makeitrielle/teleport/docs/esp32-a7670e-functional-schematic.png

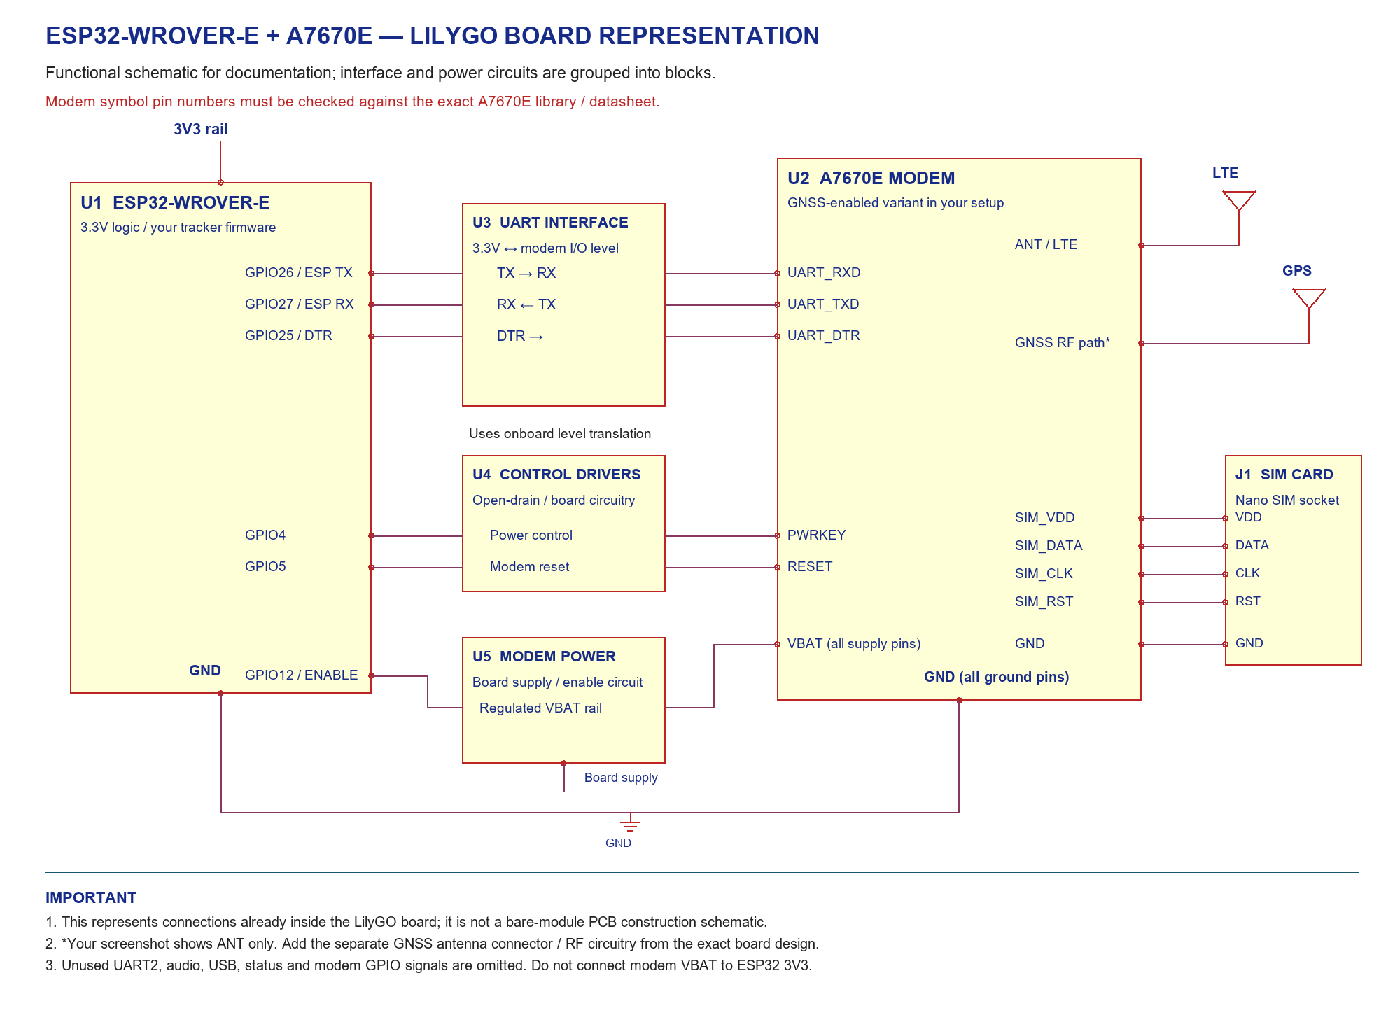
docs/esp32-a7670e-functional-schematic.png
