makeitrielle/teleport/docs/kiosk-connector-schematic.png

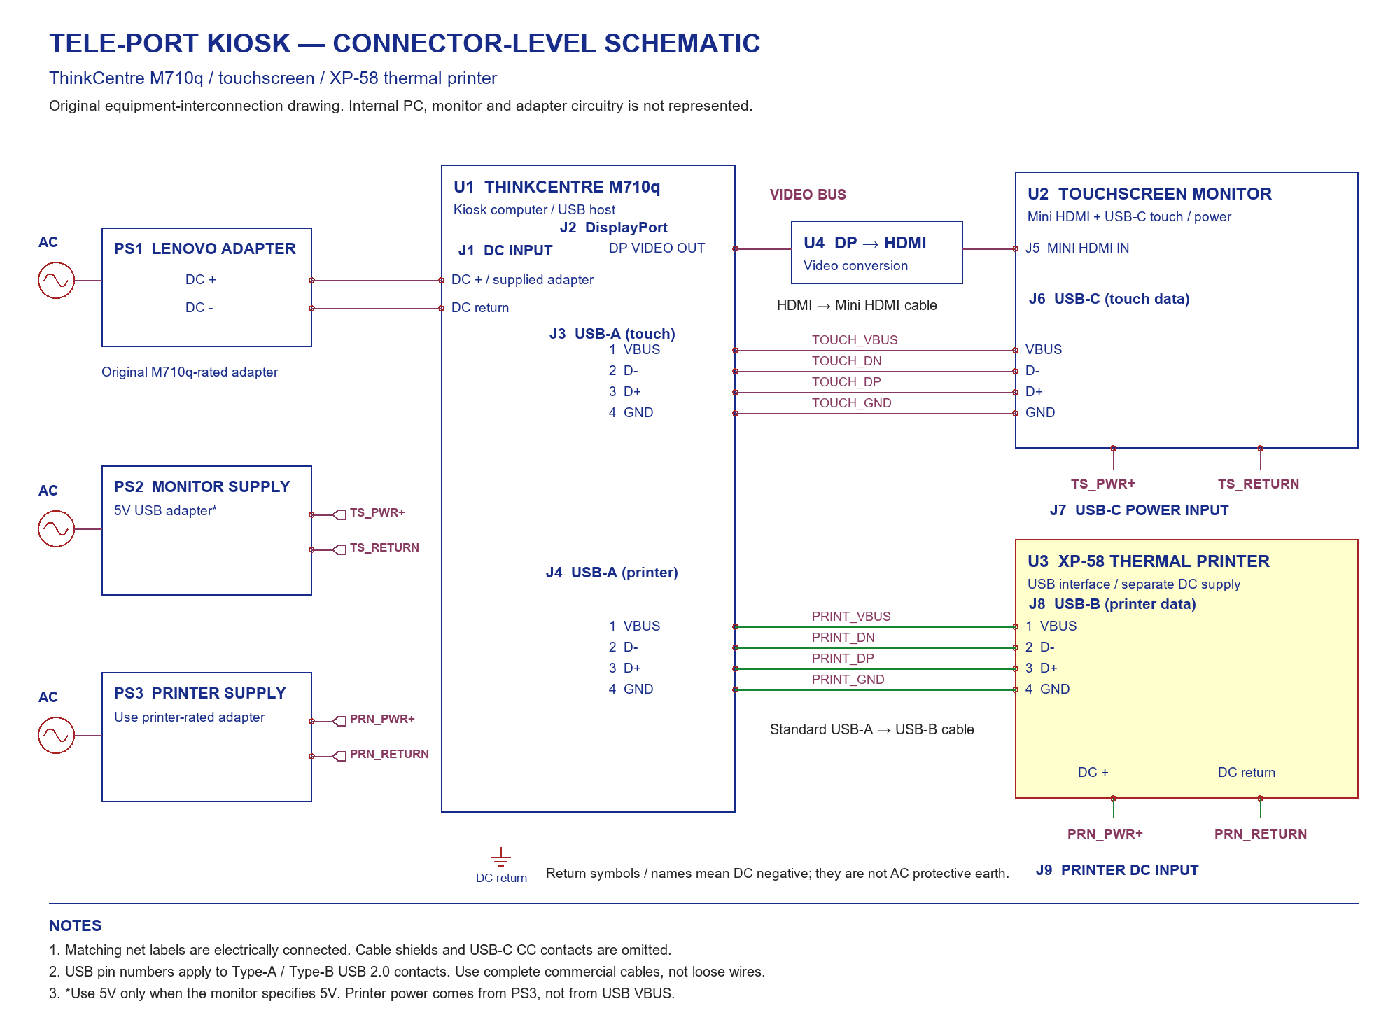
docs/kiosk-connector-schematic.png
