makeitrielle/teleport/tmp-paper-review/corrected-page-5.png

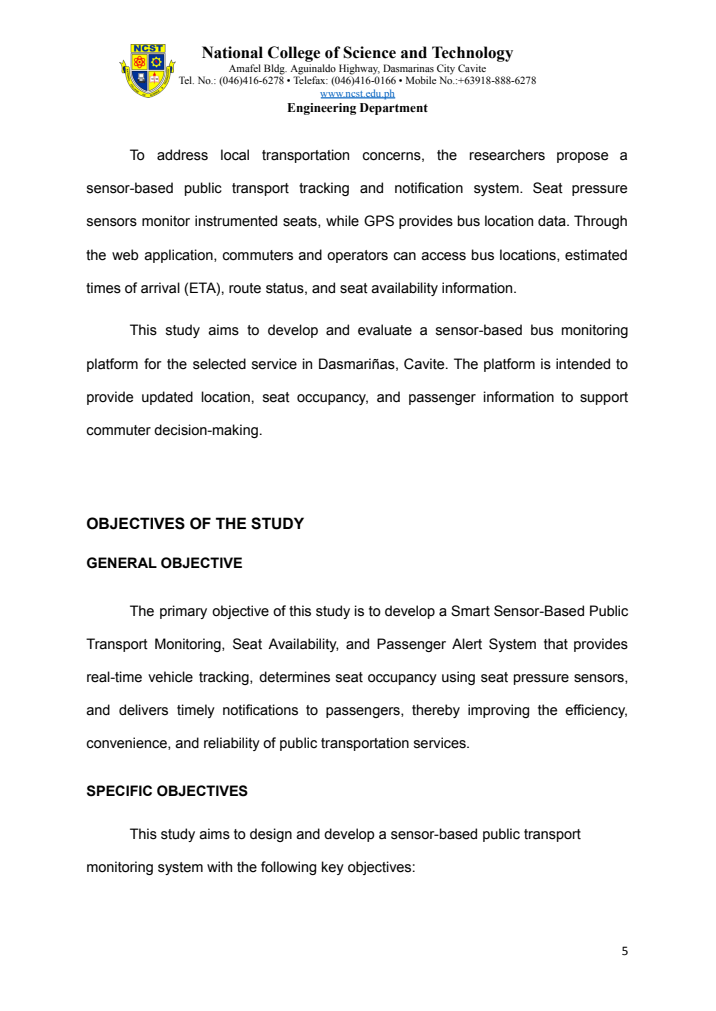
tmp-paper-review/corrected-page-5.png
