makeitrielle/teleport/tmp-paper-review/corrected-page-17.png

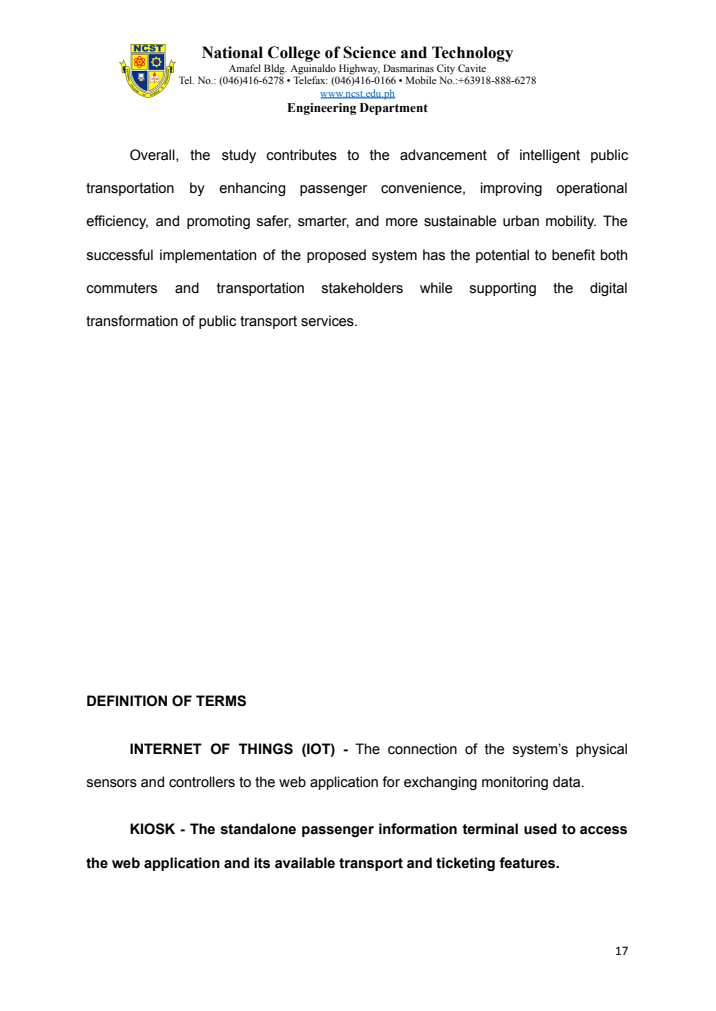
tmp-paper-review/corrected-page-17.png
