makeitrielle/teleport/tmp-paper-review/corrected-page-40.png

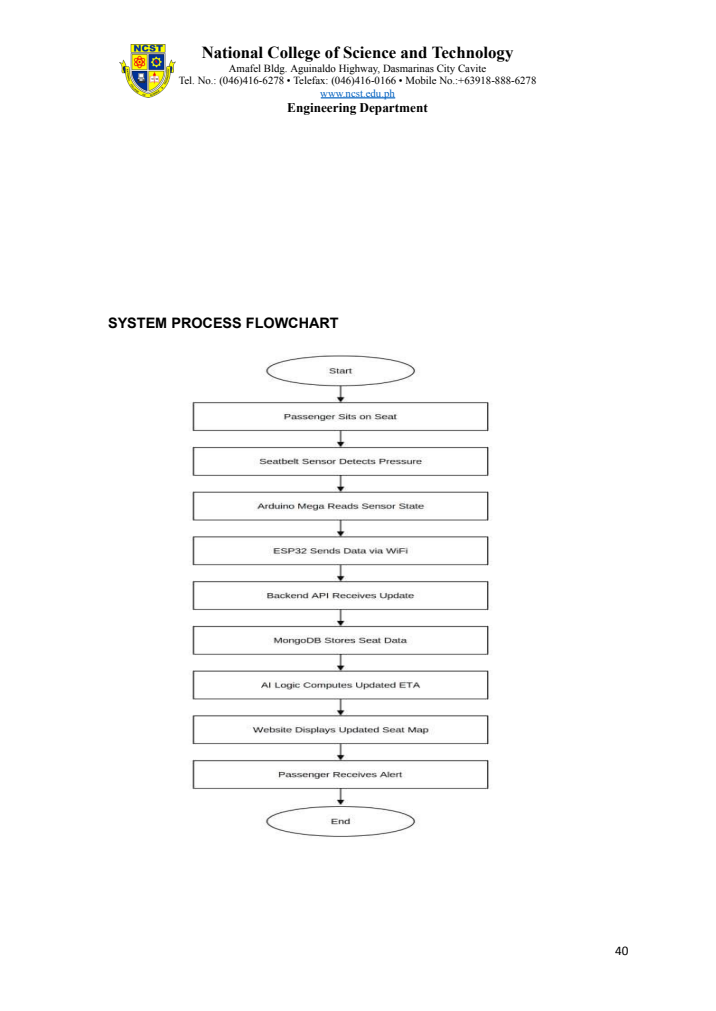
tmp-paper-review/corrected-page-40.png
