makeitrielle/teleport/tmp-paper-review/latest-overview.jpg

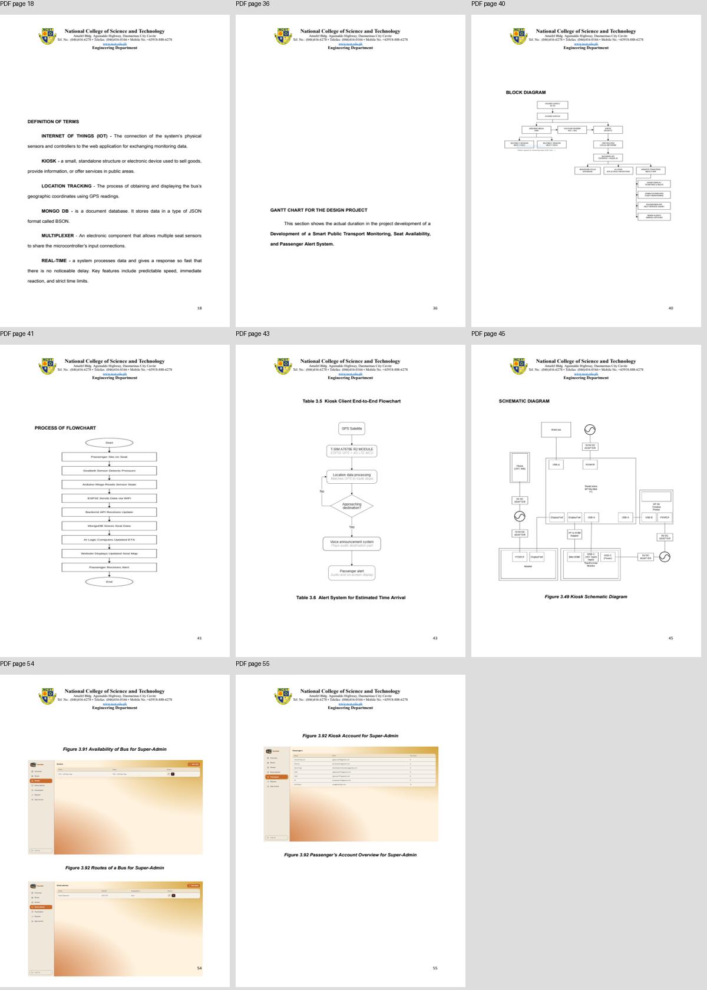
tmp-paper-review/latest-overview.jpg
