makeitrielle/teleport/tmp-paper-review/overview.jpg

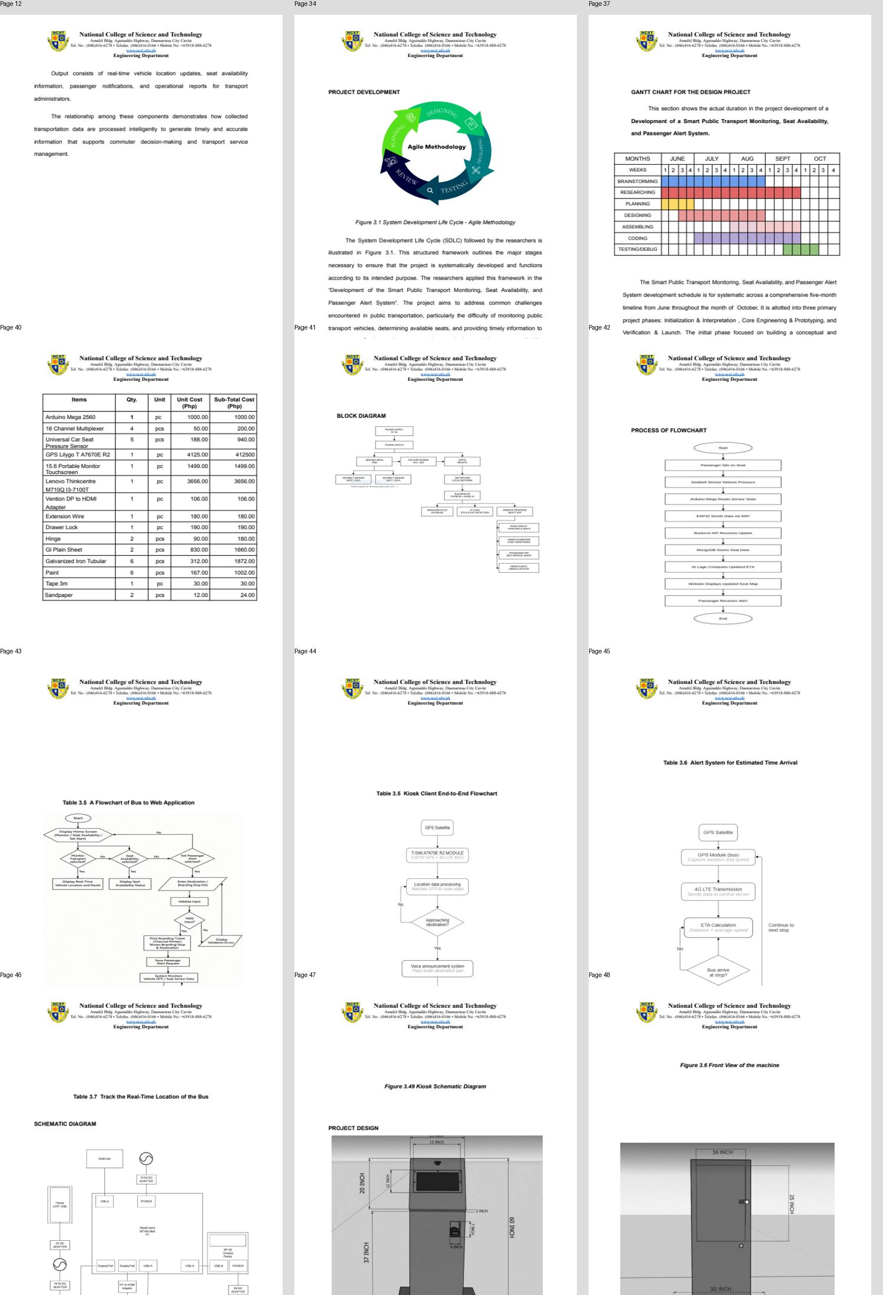
tmp-paper-review/overview.jpg
