makeitrielle/teleport/docs/kiosk-pc-touchscreen-printer-schematic.png

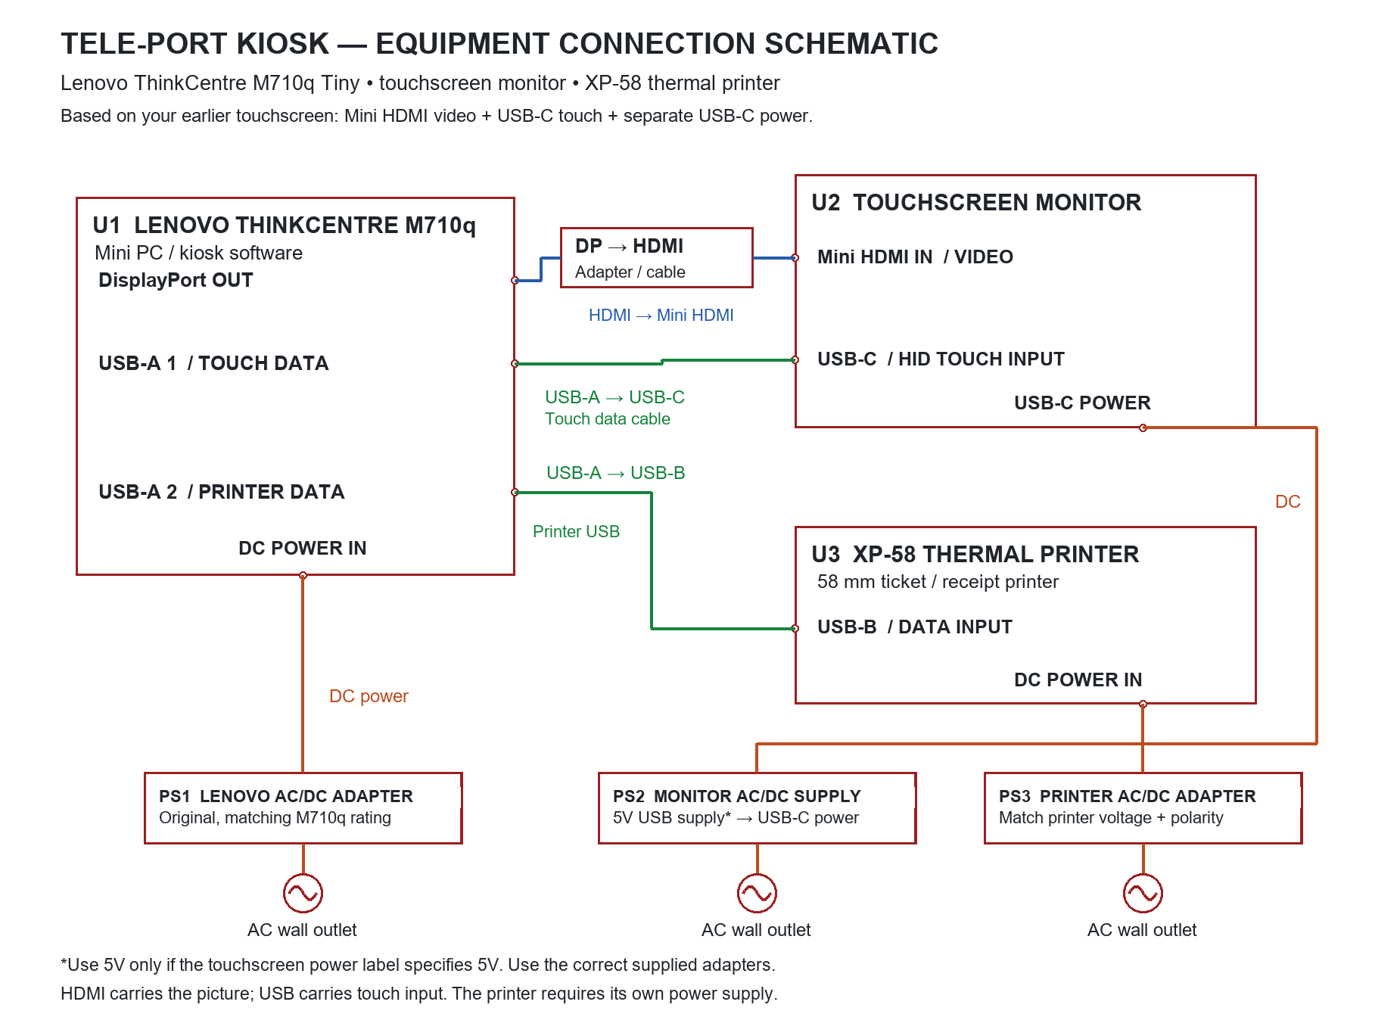
docs/kiosk-pc-touchscreen-printer-schematic.png
