makeitrielle/teleport/firmware/mega_seat_sensor/mega_seat_sensor.ino

#include <Arduino.h>
#include <DFRobotDFPlayerMini.h>
#include <stdlib.h>
#include <string.h>

/*
  TELE-PORT seat occupancy scanner and voice alert player

  Board: Arduino Mega 2560
  Sensors: 61 two-wire FLEXKYS mats via four CD74HC4067 modules
  Voice player: DFPlayer-compatible MP3-TF-16P on Mega Serial2 (TX2=16, RX2=17)

  The Mega sends SEAT,<id>,BOOKED|AVAILABLE lines to the ESP32 on Serial1.
  The ESP32 can also send VOICE,<file-number> to play /mp3/0001.mp3 etc.
*/

constexpr uint8_t NUM_SEATS = 61;

// WIRING.md documents only seats 1-5 connected to MUX1 CH0-CH4.
// Keep the count matched to the actual installed mats so unwired mux
// channels cannot produce false occupancy readings.
constexpr uint8_t ONLINE_SENSOR_COUNT = 5;

constexpr uint8_t NUM_MUXES = 4;

constexpr uint8_t MUX_SELECT_PINS[4] = {
  26, 27, 28, 29
};

constexpr uint8_t MUX_SIG_PINS[NUM_MUXES] = {
  A0, A1, A2, A3
};

// Give the mux output time to settle after changing address, then use
// a majority vote to reject brief transitions and contact noise.
constexpr unsigned long DEBOUNCE_MS = 100;
constexpr unsigned int MUX_SETTLE_US = 300;
constexpr unsigned int SAMPLE_GAP_US = 100;
constexpr uint8_t CHANNEL_SAMPLE_COUNT = 7;

// Send periodic sensor readings so the backend can distinguish
// live readings from stale last-known data.
constexpr unsigned long SENSOR_HEARTBEAT_MS = 20000;

DFRobotDFPlayerMini voicePlayer;

bool voicePlayerReady = false;

bool stableOccupied[NUM_SEATS];
bool candidateOccupied[NUM_SEATS];

unsigned long candidateSince[NUM_SEATS];
unsigned long lastSensorHeartbeat = 0;


// ------------------------------------------------------------
// Read one seat sensor
// ------------------------------------------------------------
bool readSeatOccupied(uint8_t seatIndex) {
  const uint8_t muxIndex = seatIndex / 16;
  const uint8_t channel = seatIndex % 16;

  // Set the multiplexer channel.
  for (uint8_t bit = 0; bit < 4; ++bit) {
    digitalWrite(
      MUX_SELECT_PINS[bit],
      (channel & (1U << bit)) ? HIGH : LOW
    );
  }

  // Allow the multiplexer output to settle.
  delayMicroseconds(MUX_SETTLE_US);

  // Discard the first reading after switching channels.
  // The mux SIG pin is configured as INPUT_PULLUP in setup().
  (void)digitalRead(MUX_SIG_PINS[muxIndex]);

  // Take multiple samples to reduce contact/sensor noise.
  uint8_t lowSamples = 0;

  for (uint8_t sample = 0;
       sample < CHANNEL_SAMPLE_COUNT;
       ++sample) {

    delayMicroseconds(SAMPLE_GAP_US);

    if (digitalRead(MUX_SIG_PINS[muxIndex]) == LOW) {
      ++lowSamples;
    }
  }

  // Majority vote.
  return lowSamples > CHANNEL_SAMPLE_COUNT / 2;
}


// ------------------------------------------------------------
// Report offline seat
// ------------------------------------------------------------
void reportOfflineSeat(uint8_t index) {
  const uint8_t seatId = index + 1;

  Serial1.print(F("SEAT,"));
  Serial1.print(seatId);
  Serial1.println(F(",OFFLINE"));

  Serial.print(F("SEAT,"));
  Serial.print(seatId);
  Serial.println(F(",OFFLINE"));
}


// ------------------------------------------------------------
// Report seat status
// ------------------------------------------------------------
void reportSeat(uint8_t index, bool occupied) {
  const uint8_t seatId = index + 1;

  Serial1.print(F("SEAT,"));
  Serial1.print(seatId);
  Serial1.print(',');

  Serial1.println(
    occupied
      ? F("BOOKED")
      : F("AVAILABLE")
  );

  Serial.print(F("SEAT,"));
  Serial.print(seatId);
  Serial.print(',');

  Serial.println(
    occupied
      ? F("BOOKED")
      : F("AVAILABLE")
  );
}


// ------------------------------------------------------------
// Handle ESP voice command
// ------------------------------------------------------------
void handleEspCommand(char* line) {
  if (strncmp(line, "VOICE,", 6) != 0) {
    return;
  }

  char* end = nullptr;

  const long fileNumber = strtol(
    line + 6,
    &end,
    10
  );

  if (
    end == line + 6 ||
    *end != '\0' ||
    fileNumber < 1 ||
    fileNumber > 255
  ) {
    Serial.println(F("Ignored invalid VOICE command."));
    return;
  }

  if (!voicePlayerReady) {
    Serial.println(
      F("Voice alert skipped: DFPlayer is not ready.")
    );
    return;
  }

  voicePlayer.playMp3Folder(
    static_cast<uint16_t>(fileNumber)
  );

  Serial.print(F("Playing voice clip "));
  Serial.println(fileNumber);
}


// ------------------------------------------------------------
// Poll ESP commands from Serial1
// ------------------------------------------------------------
void pollEspCommands() {
  static char line[32];
  static uint8_t length = 0;
  static bool overflow = false;

  while (Serial1.available() > 0) {

    const char c = static_cast<char>(
      Serial1.read()
    );

    // Ignore carriage return.
    if (c == '\r') {
      continue;
    }

    // Process complete line.
    if (c == '\n') {

      if (!overflow && length > 0) {
        line[length] = '\0';
        handleEspCommand(line);
      }

      length = 0;
      overflow = false;
    }

    // Add character to buffer.
    else if (!overflow) {

      if (length < sizeof(line) - 1) {
        line[length++] = c;
      }
      else {
        overflow = true;
      }
    }
  }
}


// ------------------------------------------------------------
// Setup
// ------------------------------------------------------------
void setup() {

  Serial.begin(115200);

  // Mega <-> LILYGO A7670E / ESP bridge
  Serial1.begin(9600);

  // Mega <-> DFPlayer Mini
  Serial2.begin(9600);


  // Configure multiplexer select pins.
  for (uint8_t bit = 0; bit < 4; ++bit) {

    pinMode(
      MUX_SELECT_PINS[bit],
      OUTPUT
    );

    digitalWrite(
      MUX_SELECT_PINS[bit],
      LOW
    );
  }


  // Configure multiplexer signal pins.
  for (uint8_t mux = 0; mux < NUM_MUXES; ++mux) {

    pinMode(
      MUX_SIG_PINS[mux],
      INPUT_PULLUP
    );
  }


  // Keep all muxes enabled.
  // Their EN pins are wired to GND.
  delay(10);


  // Initialize DFPlayer.
  voicePlayerReady = voicePlayer.begin(
    Serial2,
    true,
    true
  );

  if (voicePlayerReady) {

    voicePlayer.setTimeOut(500);

    // Volume range: 0-30
    voicePlayer.volume(20);

    Serial.println(
      F("DFPlayer ready.")
    );
  }
  else {

    Serial.println(
      F("DFPlayer not found; seat monitoring will continue.")
    );
  }


  // Initialize seat states.
  const unsigned long now = millis();

  for (uint8_t i = 0; i < NUM_SEATS; ++i) {

    candidateSince[i] = now;

    // Only currently connected sensors are read.
    if (i < ONLINE_SENSOR_COUNT) {

      stableOccupied[i] = readSeatOccupied(i);

      candidateOccupied[i] =
        stableOccupied[i];


      // Debug information.
      Serial.print(F("MUX "));
      Serial.print((i / 16) + 1);

      Serial.print(F(" CH"));
      Serial.print(i % 16);

      Serial.print(F(" -> seat "));
      Serial.print(i + 1);

      Serial.print(F(": "));

      Serial.println(
        stableOccupied[i]
          ? F("occupied")
          : F("available")
      );


      // Send initial state.
      reportSeat(
        i,
        stableOccupied[i]
      );
    }

    // Seats without physical sensors are marked offline.
    else {

      stableOccupied[i] = false;
      candidateOccupied[i] = false;

      reportOfflineSeat(i);
    }
  }


  Serial.println(
    F("Ready: seats 1-5 online; seats 6-61 reported offline.")
  );
}


// ------------------------------------------------------------
// Main loop
// ------------------------------------------------------------
void loop() {

  // Check commands from ESP.
  pollEspCommands();


  const unsigned long now = millis();


  // Read currently connected sensors.
  for (
    uint8_t i = 0;
    i < ONLINE_SENSOR_COUNT;
    ++i
  ) {

    const bool readingOccupied =
      readSeatOccupied(i);


    // A new candidate state was detected.
    if (
      readingOccupied !=
      candidateOccupied[i]
    ) {

      candidateOccupied[i] =
        readingOccupied;

      candidateSince[i] = now;
    }


    // Candidate state has remained stable long enough.
    else if (
      readingOccupied != stableOccupied[i] &&
      now - candidateSince[i] >= DEBOUNCE_MS
    ) {

      stableOccupied[i] =
        readingOccupied;

      reportSeat(
        i,
        stableOccupied[i]
      );
    }
  }


  // ----------------------------------------------------------
  // Sensor heartbeat
  //
  // Refresh backend timestamps even when occupancy has not
  // changed. This lets the website distinguish live readings
  // from stale last-known data.
  // ----------------------------------------------------------
  if (
    now - lastSensorHeartbeat >=
    SENSOR_HEARTBEAT_MS
  ) {

    lastSensorHeartbeat = now;

    for (
      uint8_t i = 0;
      i < ONLINE_SENSOR_COUNT;
      ++i
    ) {

      reportSeat(
        i,
        stableOccupied[i]
      );
    }
  }
}
