makeitrielle/teleport/firmware/esp_wifi_bridge/device_config.example.h

#pragma once
// Copy to device_config.h. This legacy bridge is for a trusted development LAN.
// Use the authenticated HTTPS LilyGO tracker for production telemetry.
#define TELEPORT_DEVICE_KEY "replace-with-this-bus-device-key"
